designbyadil-dev/picoMIPS-gaussian-smoothing/rtl/alucodes.sv

//-----------------------------------------------------
// File Name   : alucodes.sv
// Function    : picoMIPS ALU function code definitions
//               Optimised version — ar7n25
//-----------------------------------------------------
`define RA    3'b000   // pass A
`define RB    3'b001   // pass B
`define RADD  3'b010   // A + B
`define RSUB  3'b011   // A - B
`define RNOP  3'b111   // no operation
